btheobald/swansong/boardartswiftneg.png

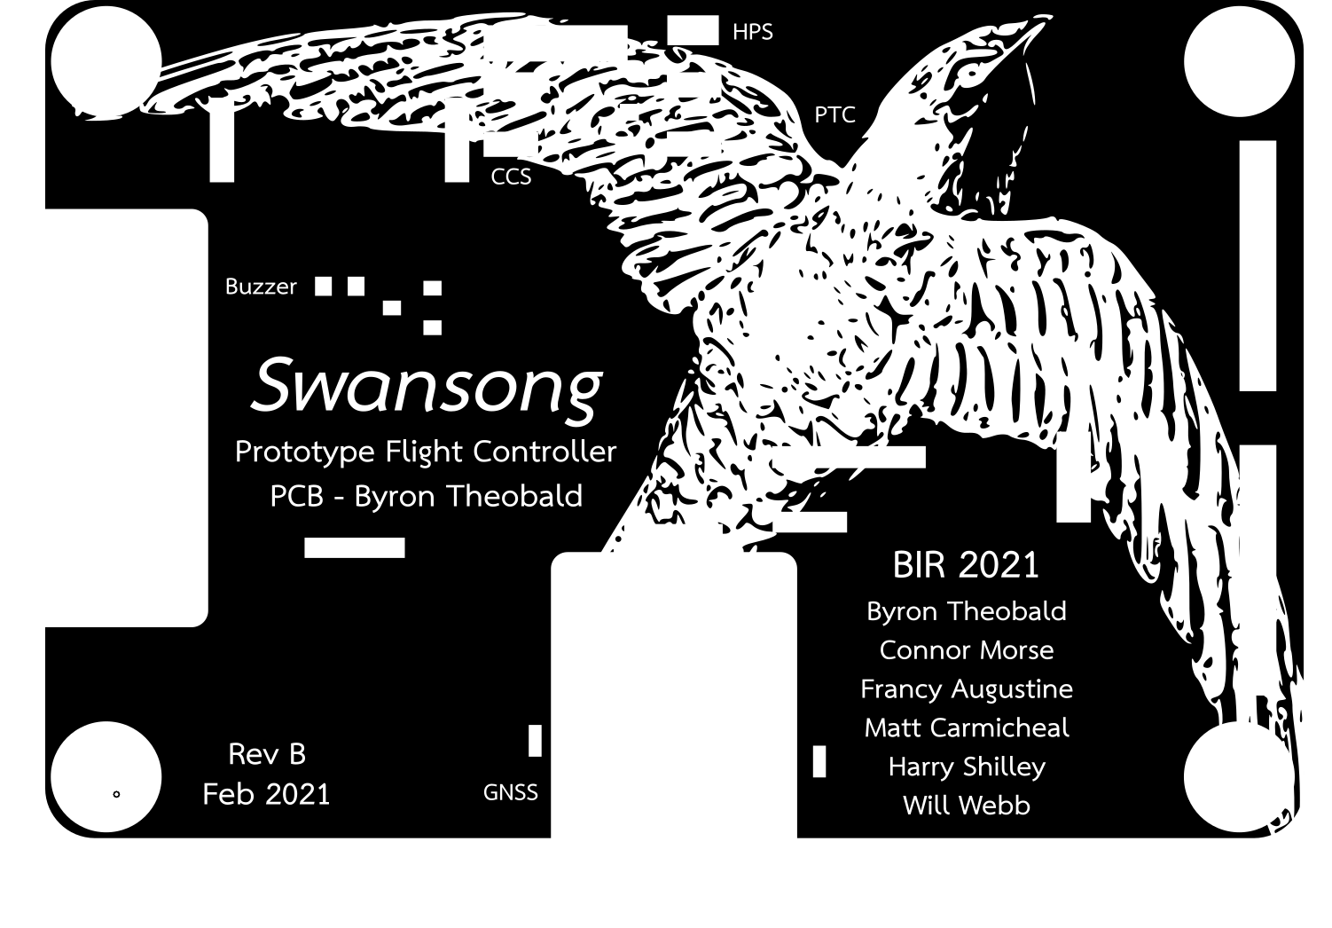
boardartswiftneg.png
