btheobald/swansong/boardartswiftpos.png

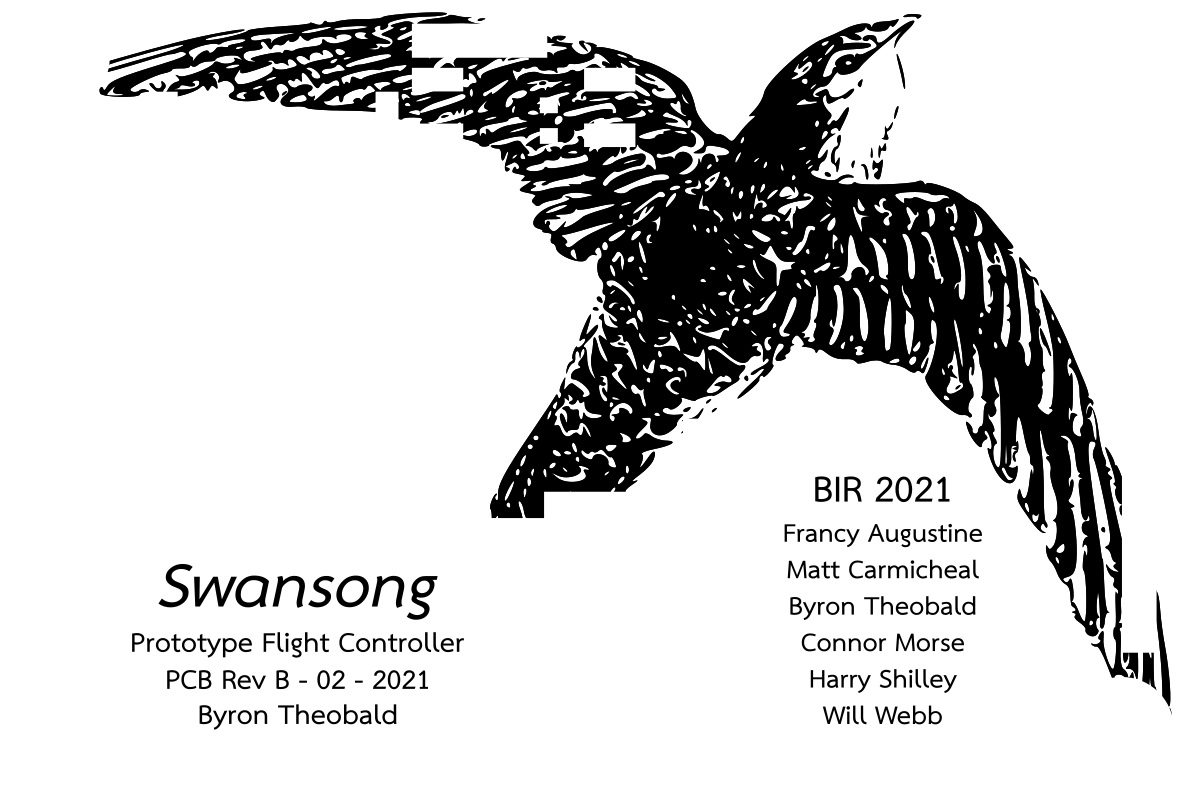
boardartswiftpos.png
