btheobald/swansong/rect2757.png

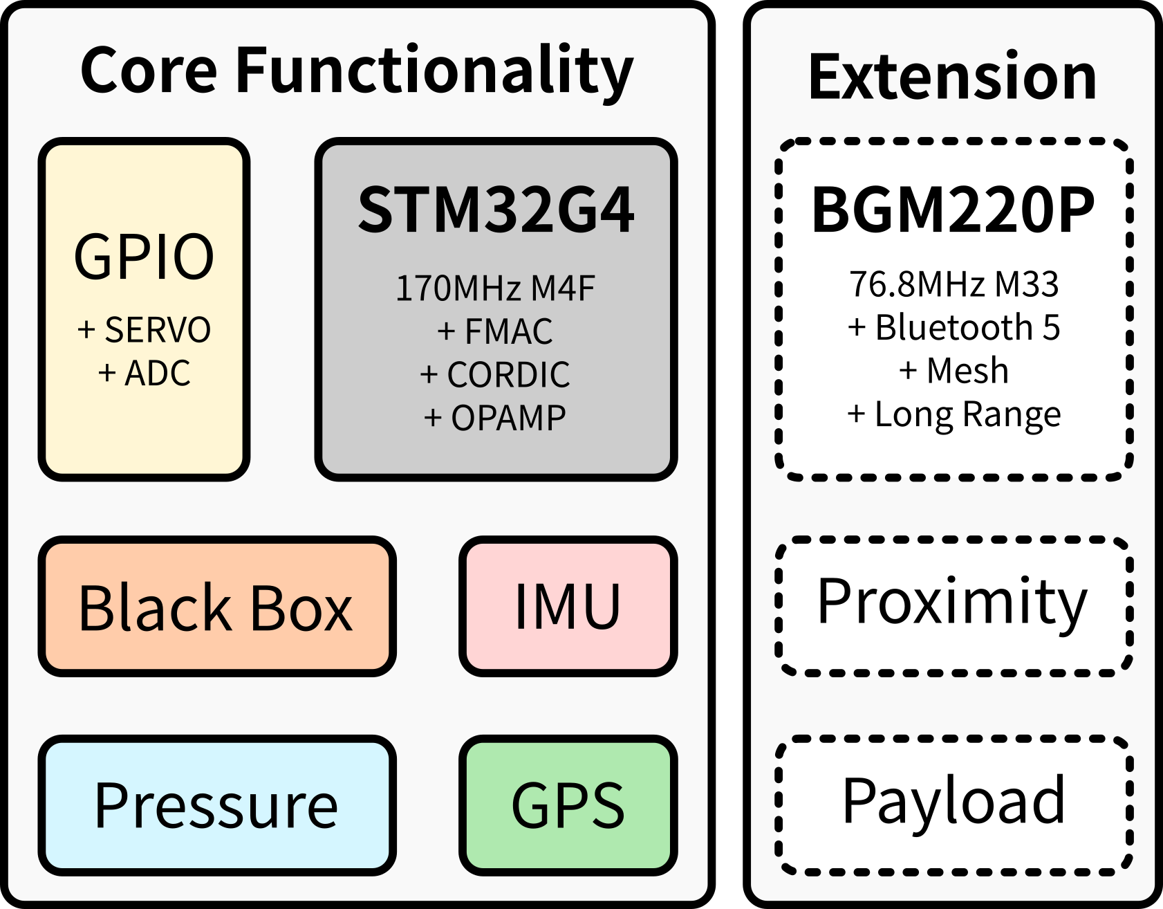
rect2757.png
