btheobald/swansong/glider/bom.ods

Reference | Quantity | Value | Footprint | Order Number | Min Qty | Price | Actual Order Qty | Phase 1 Order Price
C10 C11 C12 C13 C17 C26 | 6 | 4.7u | 0603 10V | 3013398 | 10 | 0.0325 | 20 | 0.65
C1 C2 C5 C6 C7 C9 C14 C15 C16 C18 C19 C20 C21 C23 C25 C27 C28 C29 C30 C33 C42 | 21 | 0.1u | 0402 10V | 2627343 | 100 | 0.0058 | 100 | 0.58
C3 C4 | 2 | 12p | 0402 50V | 3369114 | 10 | 0.0205 | 10 | 0.205
C8 C22 C31 C32 C34 C35 C36 C37 C38 C39 C40 C41 | 12 | 10u | 0805 16V | 3013453 | 50 | 0.0485 | 50 | 2.425
D2 D9 D8 D6 | 4 | Green | LED 0603 | 2290328 | 5 | 0.1704 | 10 | 1.704
D1 D5 D7 D4 | 4 | Red | LED 0603 | 2099224 | 5 | 0.1452 | 10 | 1.452
D3 | 1 | D_Schottky | Diode_SMD:D_SOD-123 | 2400193 | 5 | 0.3384 | 5 | 1.692
F1 | 1 | 1.5A | 1.5A 8VDC 1206 PTC | 2834894 | 1 | 0.1824 | 2 | 0.3648
J19 | 1 | Micro_SD_Card | DM3CS-SF | 1764376 | 1 | 1.332 | 2 | 2.664
J1 | 1 | USB_B_Micro | Connector_USB:USB_Micro-B_Molex_47346-0001 | 1568026 | 1 | 0.8964 | 2 | 1.7928
LS1 | 1 | Speaker | PKLCS1212E40A1-R1 | 2443208 | 1 | 0.9588 | 2 | 1.9176
Q1 | 1 | Q_PMOS_DGS | Package_TO_SOT_SMD:SOT-23 | 3577037 | 5 | 0.1812 | 5 | 0.906
Q2 Q3 | 2 | Q_NMOS_DGS | Package_TO_SOT_SMD:SOT-23 | 3577032 | 5 | 0.0403 | 5 | 0.2015
R1 | 1 | 2k | Resistor_SMD:R_0603_1608Metric | 2502426 | 10 | 0.0042 | 10 | 0.042
R11 R12 | 2 | 5.7k | Resistor_SMD:R_0603_1608Metric | 2670834 | 10 | 0.0042 | 10 | 0.042
R13 R14 R18 R21 | 4 | 0 | Resistor_SMD:R_0402_1005Metric | 2668188 | 10 | 0.0036 | 20 | 0.072
R4 | 1 | 0.1 | Resistor_SMD:R_1210_3225Metric | 3399742 | 1 | 0.2916 | 2 | 0.5832
R3 R5 R6 R7 R16 R19 R23 R24 R25 R26 R27 R30 | 12 | 100k | Resistor_SMD:R_0603_1608Metric | 2502398 | 10 | 0.014 | 40 | 0.56
R2 R8 R9 R10 R15 R17 R20 R29 R31 | 9 | 1k | Resistor_SMD:R_0603_1608Metric | 2502396 | 10 | 0.0148 | 20 | 0.296
SW1, SW2, SW3, SW4 | 4 | NCP_USER | PTS810 260gf | 3023215 | 10 | 0.1812 | 10 | 1.812
U10 | 1 | MIC5504-1.8YM5-TR | Package_TO_SOT_SMD:SOT-23-5 | 2809977 | 1 | 0.109 | 2 | 0.218
U11 | 1 | NTB0104BQ | 14-DHVQFN | 2890102 | 1 | 1.044 | 2 | 2.088
U2 | 1 | STM32G484RETx | Package_QFP:LQFP-64_10x10mm_P0.5mm | 3132422 | 1 | 7.092 | 2 | 14.184
U3 | 1 | MIC5501-3.0YM5-TR | Package_TO_SOT_SMD:SOT-23-5 | 2857640 | 1 | 0.109 | 2 | 0.218
U4 | 1 | MCP73831-2-OT | Package_TO_SOT_SMD:SOT-23-5 | 1332158 | 1 | 0.5544 | 2 | 1.1088
U5 | 1 | MS5637 | atlas:QFN-4_3x3_Pitch2mm | 3397823 | 1 | 2.748 | 2 | 5.496
U6 | 1 | AT25SF641-SUB-T | 8-WSOIC | 2988514 | 1 | 1.1208 | 2 | 2.2416
U7 | 1 | ICM-20948 | Package_DFN_QFN:QFN-24-1EP_3x3mm_P0.4mm_EP1.75x1.6mm | 2911498 | 1 | 6.696 | 2 | 13.392
U8 | 1 | L96-M33 | atlas:L96 | https://www.aliexpress.com/item/10000106848456.html | 1 | 6.9 | 2 | 13.8
Y1 | 1 | 8MHz | Crystal:Crystal_SMD_SeikoEpson_FA238-4Pin_3.2x2.5mm | 3501659 | 1 | 0.9084 | 2 | 1.8168
 |  |  |  |  |  |  | Total | 74.5251
