btheobald/swansong/glider/DM3CS-SF.stp

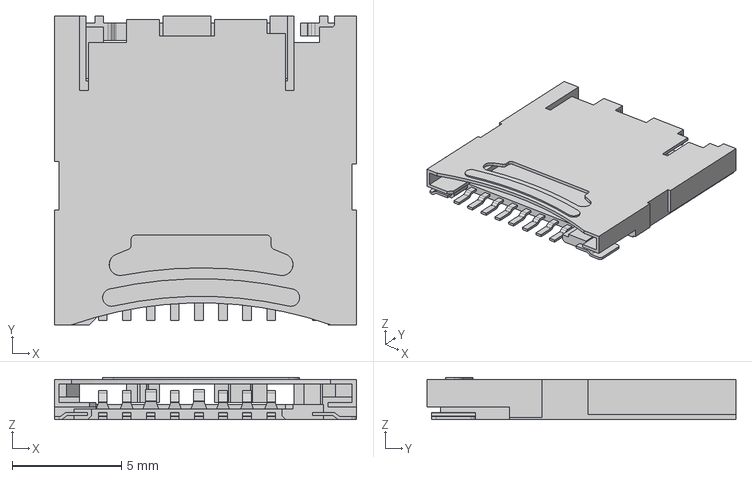
[picture p4: CAD file, 2021-02-24]
glider/DM3CS-SF.stp
13.8 x 14.1 x 1.93 mm
