btheobald/swansong/glider/glider.kicad_pcb

## KiCad design glider/glider.kicad_pcb (2021-03-01)

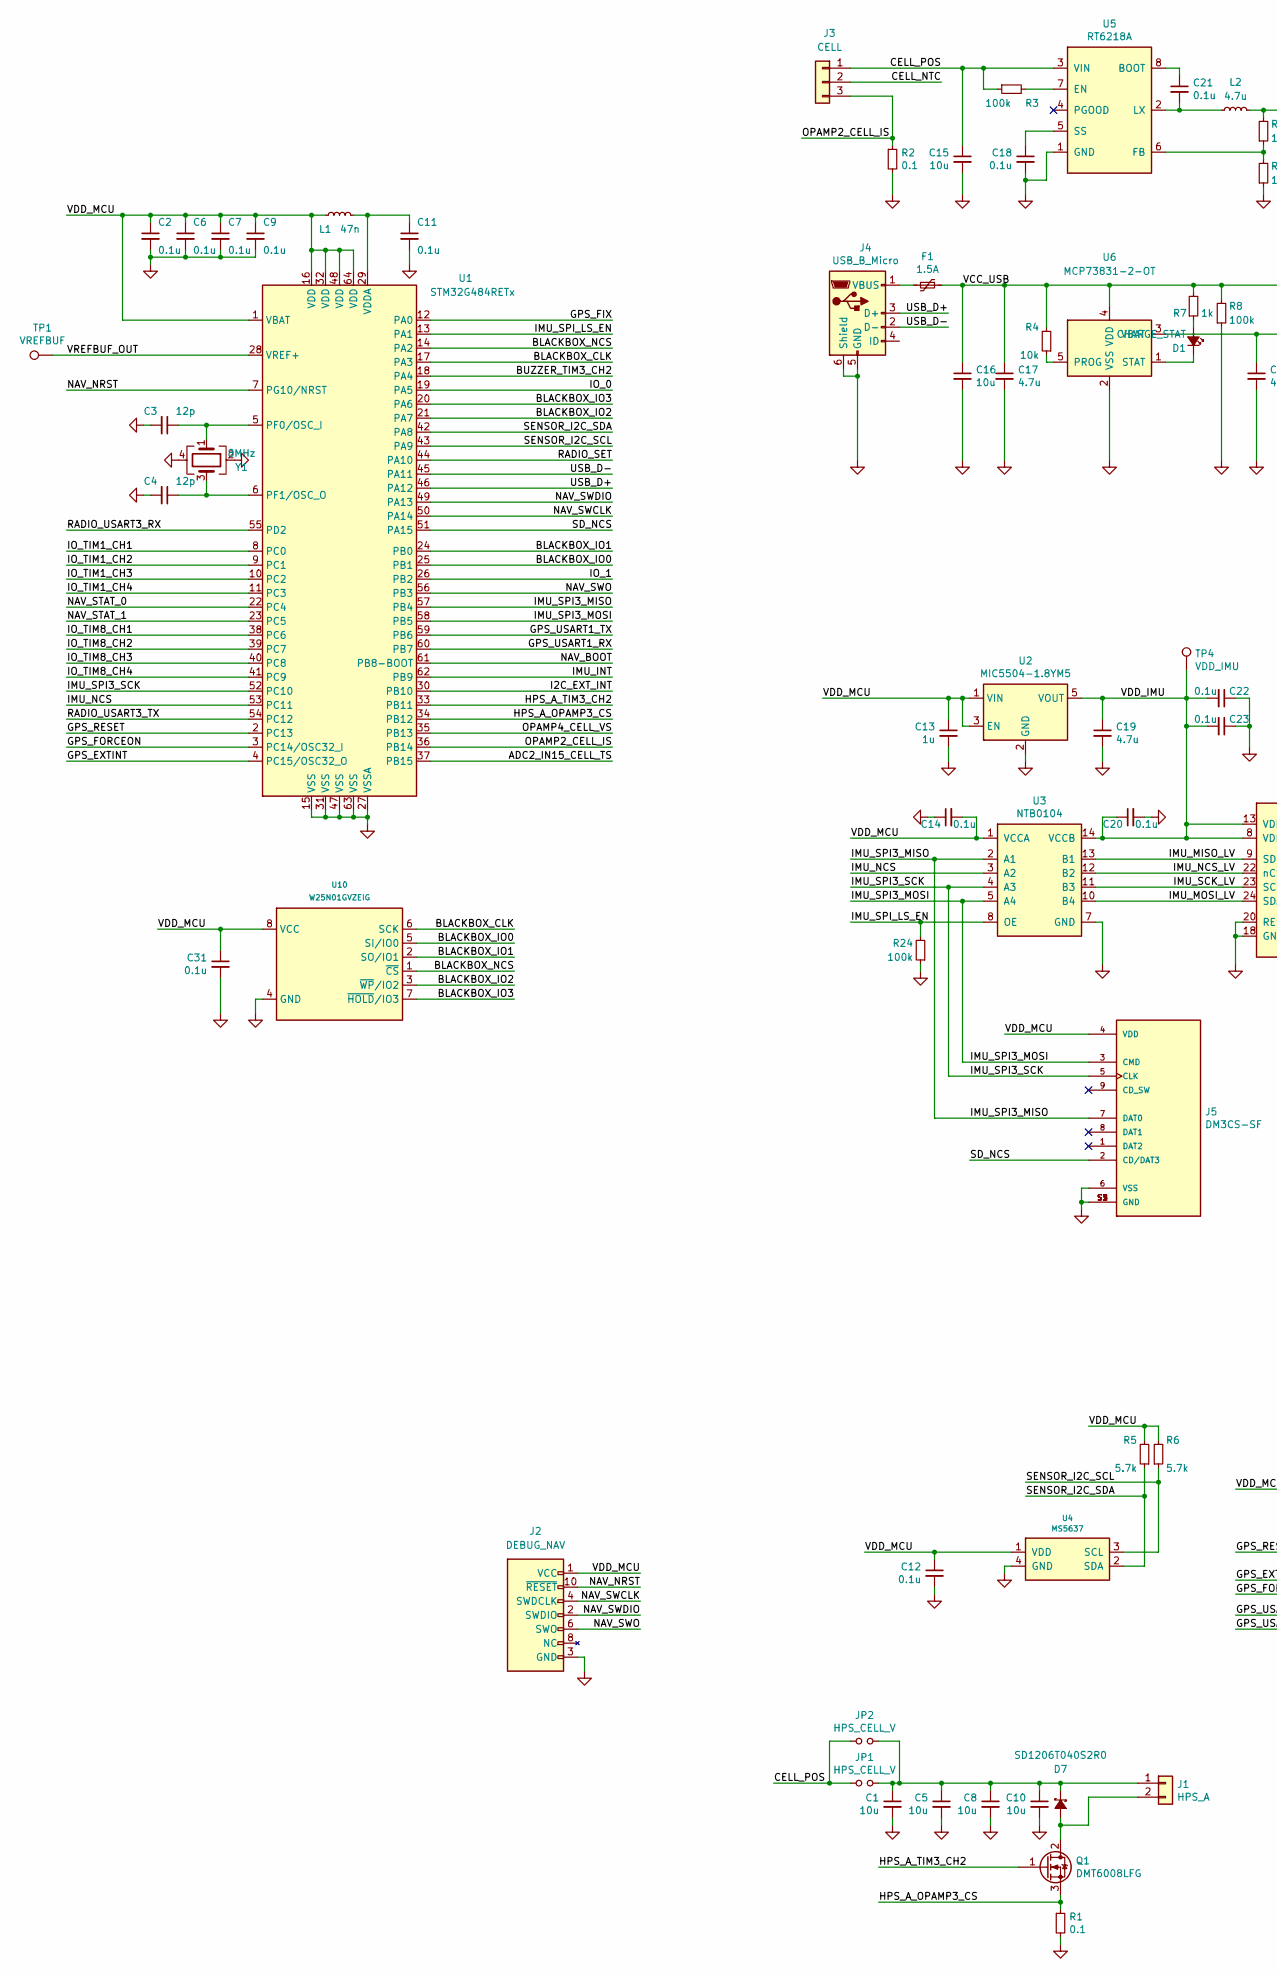
[picture p5: schematic glider.sch, part in row 1, column 1]

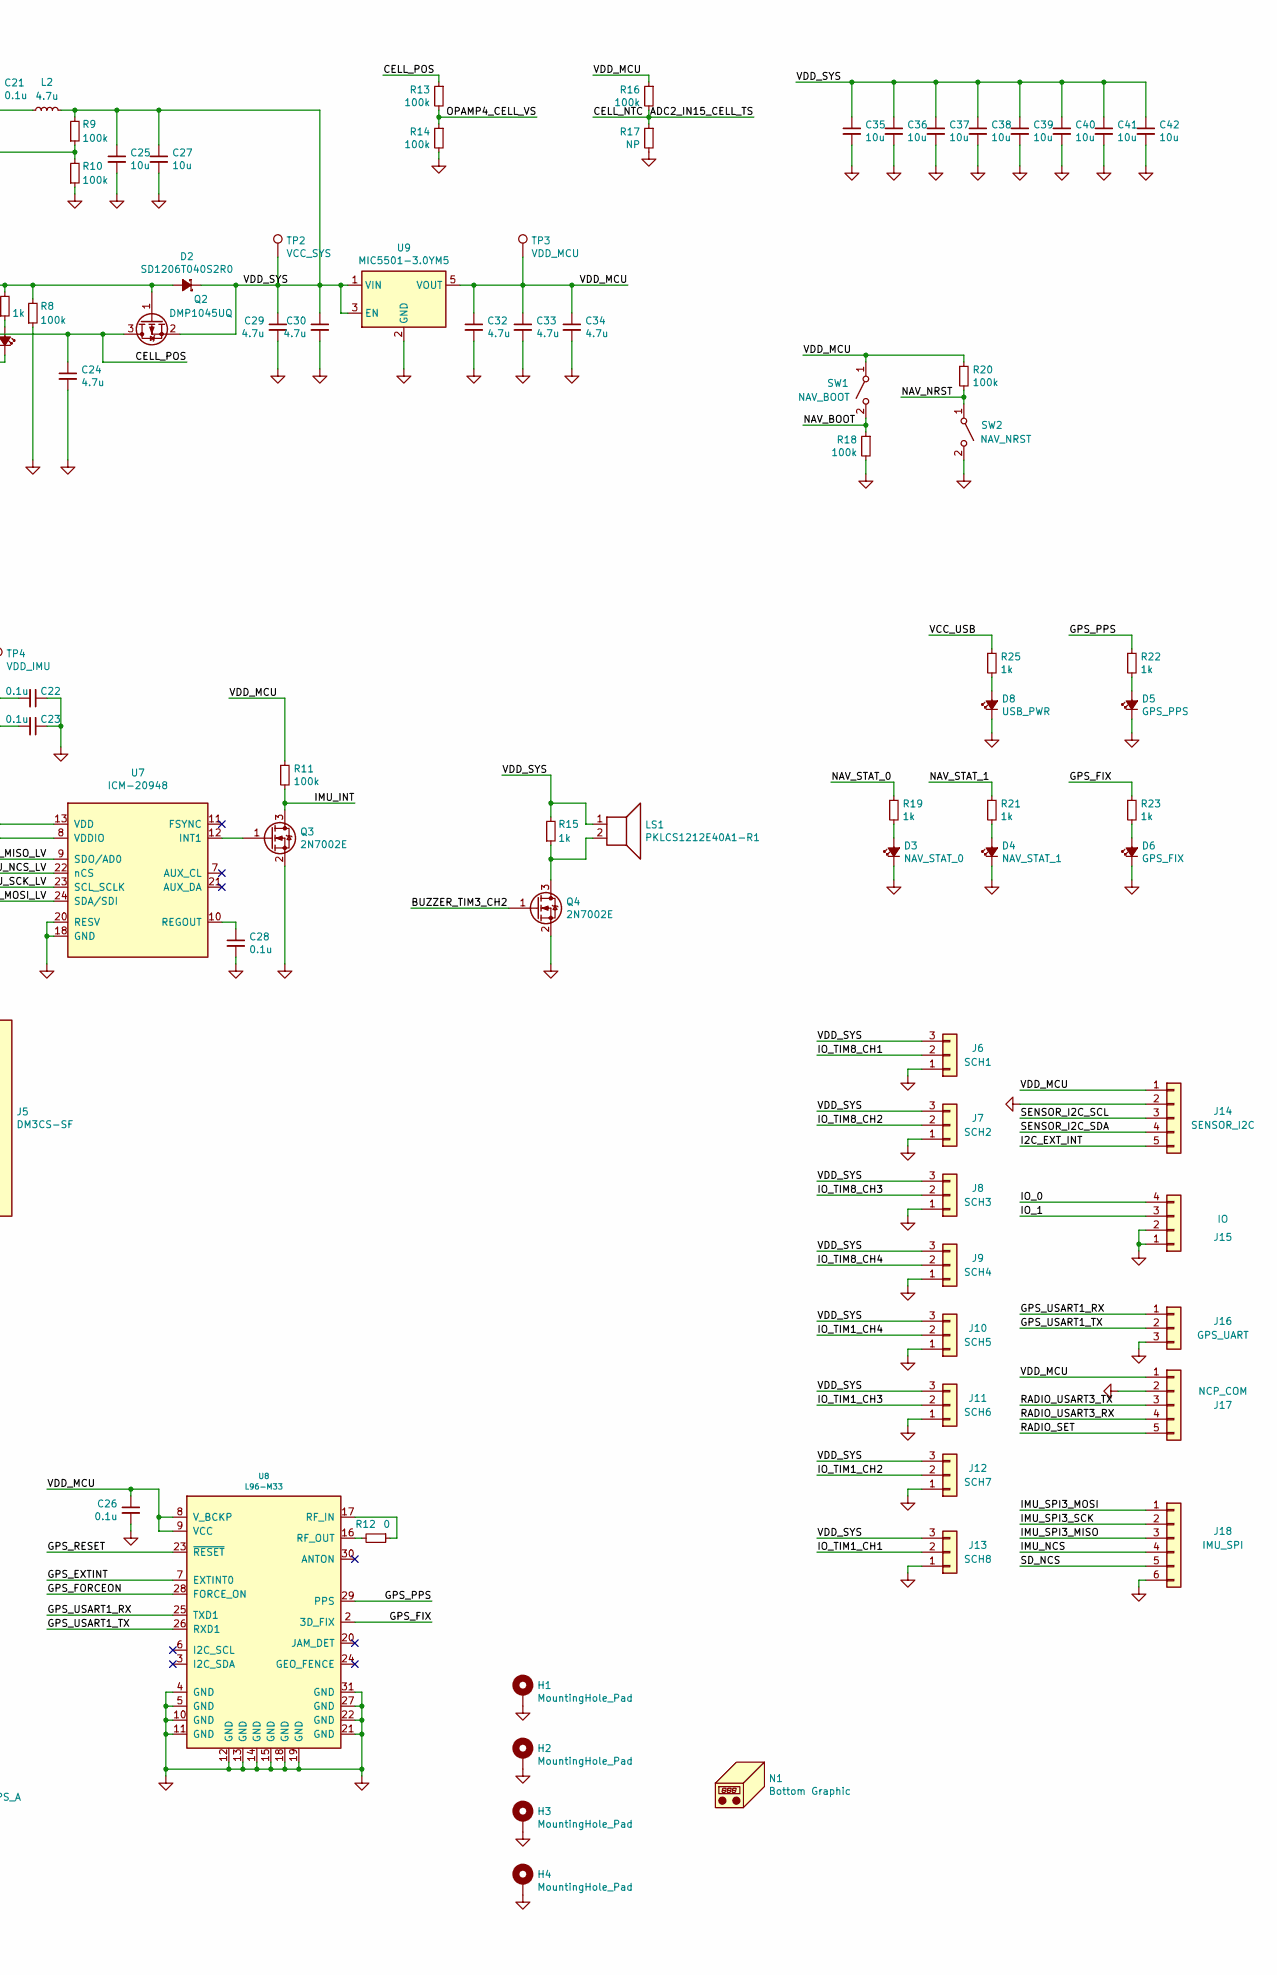
[picture p6: schematic glider.sch, part in row 1, column 2]

Parts:
C1, C5, C8, C10: 10u; C_1206_3216Metric
C2, C6, C7, C9, C11, C12, C14, C18, C20, C21, C22, C23, C26, C28, C31: 0.1u; C_0402_1005Metric
C3, C4: 12p; C_0402_1005Metric
C13: 1u; C_0805_2012Metric
C15, C16, C25, C27, C35, C36, C37, C38, C39, C40, C41, C42: 10u; C_0805_2012Metric
C17, C19, C24, C29, C30, C32, C33, C34: 4.7u; C_0805_2012Metric
D1: CHARGE_STAT; LED_0603_1608Metric
D2, D7: SD1206T040S2R0; D_SOD-123
D3: NAV_STAT_0; LED_0603_1608Metric
D4: NAV_STAT_1; LED_0603_1608Metric
D5: GPS_PPS; LED_0603_1608Metric
D6: GPS_FIX; LED_0603_1608Metric
D8: USB_PWR; LED_0603_1608Metric
F1: 1.5A; R_1210_3225Metric
H1, H2, H3, H4: MountingHole_Pad; MountingHole_2.5mm_Pad_Via
J1: HPS_A; R_2816_7142Metric_Pad3.20x4.45mm_HandSolder
J2: DEBUG_NAV; PinHeader_2x05_P1.27mm_Vertical_SMD
J3: CELL; PinSocket_1x03_P2.54mm_Vertical
J4: USB_B_Micro; USB_Micro-B_Molex_47346-0001
J5: DM3CS-SF; HRS_DM3CS-SF; PARTREV n/a
J6: SCH1; PinHeader_1x03_P2.54mm_Vertical
J7: SCH2; PinHeader_1x03_P2.54mm_Vertical
J8: SCH3; PinHeader_1x03_P2.54mm_Vertical
J9: SCH4; PinHeader_1x03_P2.54mm_Vertical
J10: SCH5; PinHeader_1x03_P2.54mm_Vertical
J11: SCH6; PinHeader_1x03_P2.54mm_Vertical
J12: SCH7; PinHeader_1x03_P2.54mm_Vertical
J13: SCH8; PinHeader_1x03_P2.54mm_Vertical
J14: SENSOR_I2C; PinHeader_1x05_P2.54mm_Vertical
J15: IO; PinHeader_1x04_P1.27mm_Vertical
J16: GPS_UART; PinHeader_1x03_P1.27mm_Vertical
J17: NCP_COM; PinHeader_1x05_P2.54mm_Vertical
J18: IMU_SPI; PinHeader_1x06_P1.27mm_Vertical
JP1, JP2: HPS_CELL_V; SolderJumper-2_P1.3mm_Open_TrianglePad1.0x1.5mm
L1: 47n; L_0402_1005Metric
L2: 4.7u; L_Bourns-SRN4018
LS1: PKLCS1212E40A1-R1; PKLCS1212
N1: Bottom Graphic; boardartswift
Q1: DMT6008LFG; Diodes_PowerDI3333-8
Q2: DMP1045UQ; SOT-23
Q3, Q4: 2N7002E; SOT-23
R1, R2: 0.1; R_1210_3225Metric
R3, R8, R9, R10, R11, R13, R14, R16, R18, R20, R24: 100k; R_0603_1608Metric
R4: 10k; R_0603_1608Metric
R5, R6: 5.7k; R_0603_1608Metric
R7, R15, R19, R21, R22, R23, R25: 1k; R_0603_1608Metric
R12: 0; R_0402_1005Metric
R17: NP; R_0603_1608Metric
SW1: NAV_BOOT; SW_SPST_PTS810
SW2: NAV_NRST; SW_SPST_PTS810
TP1: VREFBUF; TestPoint_THTPad_D1.0mm_Drill0.5mm
TP2: VCC_SYS; TestPoint_THTPad_D1.0mm_Drill0.5mm
TP3: VDD_MCU; TestPoint_THTPad_D1.0mm_Drill0.5mm
TP4: VDD_IMU; TestPoint_THTPad_D1.0mm_Drill0.5mm
U1: STM32G484RETx; LQFP-64_10x10mm_P0.5mm
U2: MIC5504-1.8YM5; SOT-23-5
U3: NTB0104; WQFN-14-1EP_2.5x3mm_P0.5mm_EP1.45x1.00mm
U4: MS5637; QFN-4_3x3_Pitch2mm
U5: RT6218A; SOT-23-8
U6: MCP73831-2-OT; SOT-23-5
U7: ICM-20948; QFN-24-1EP_3x3mm_P0.4mm_EP1.75x1.6mm
U8: L96-M33; L96
U9: MIC5501-3.0YM5; SOT-23-5
U10: W25N01GVZEIG; WSON-8x6mm-Pad-3.4x4.3mm
Y1: 8MHz; Crystal_SMD_SeikoEpson_FA238-4Pin_3.2x2.5mm

Connections:
/ADC2_IN15_CELL_TS: J3.2, R16.2, R17.1, U1.37 (PB15)
/BLACKBOX_CLK: U1.17 (PA3), U10.6 (SCK)
/BLACKBOX_IO0: U1.25 (PB1), U10.5 (SI/IO0)
/BLACKBOX_IO1: U1.24 (PB0), U10.2 (SO/IO1)
/BLACKBOX_IO2: U1.21 (PA7), U10.3 (~WP~/IO2)
/BLACKBOX_IO3: U1.20 (PA6), U10.7 (~HOLD~/IO3)
/BLACKBOX_NCS: U1.14 (PA2), U10.1 (~CS)
/BUZZER_TIM3_CH2: Q4.1 (G), U1.18 (PA4)
/CELL_POS: C15.1, C24.1, J3.1, JP1.1, JP2.1, Q2.3 (D), R3.1, R13.1, U5.3 (VIN), U6.3 (VBAT)
/GPS_EXTINT: U1.4 (PC15/OSC32_O), U8.7 (EXTINT0)
/GPS_FIX: R23.1, U1.12 (PA0), U8.2 (3D_FIX)
/GPS_FORCEON: U1.3 (PC14/OSC32_I), U8.28 (FORCE_ON)
/GPS_PPS: R22.1, U8.29 (PPS)
/GPS_RESET: U1.2 (PC13), U8.23 (~RESET)
/GPS_USART1_RX: J16.1, U1.60 (PB7), U8.25 (TXD1)
/GPS_USART1_TX: J16.2, U1.59 (PB6), U8.26 (RXD1)
/HPS_A_OPAMP3_CS: Q1.3 (S), R1.1, U1.34 (PB12)
/HPS_A_TIM3_CH2: Q1.1 (G), U1.33 (PB11)
/I2C_EXT_INT: J14.5, U1.30 (PB10)
/IMU_INT: Q3.3 (D), R11.2, U1.62 (PB9)
/IMU_MISO_LV: U3.13 (B1), U7.9 (SDO/AD0)
/IMU_MOSI_LV: U3.10 (B4), U7.24 (SDA/SDI)
/IMU_NCS: J18.4, U1.53 (PC11), U3.3 (A2)
/IMU_NCS_LV: U3.12 (B2), U7.22 (nCS)
/IMU_SCK_LV: U3.11 (B3), U7.23 (SCL_SCLK)
/IMU_SPI3_MISO: J5.7 (DAT0), J18.3, U1.57 (PB4), U3.2 (A1)
/IMU_SPI3_MOSI: J5.3 (CMD), J18.1, U1.58 (PB5), U3.5 (A4)
/IMU_SPI3_SCK: J5.5 (CLK), J18.2, U1.52 (PC10), U3.4 (A3)
/IMU_SPI_LS_EN: R24.2, U1.13 (PA1), U3.8 (OE)
/IO_0: J15.4, U1.19 (PA5)
/IO_1: J15.3, U1.26 (PB2)
/IO_TIM1_CH1: J13.2, U1.8 (PC0)
/IO_TIM1_CH2: J12.2, U1.9 (PC1)
/IO_TIM1_CH3: J11.2, U1.10 (PC2)
/IO_TIM1_CH4: J10.2, U1.11 (PC3)
/IO_TIM8_CH1: J6.2, U1.38 (PC6)
/IO_TIM8_CH2: J7.2, U1.39 (PC7)
/IO_TIM8_CH3: J8.2, U1.40 (PC8)
/IO_TIM8_CH4: J9.2, U1.41 (PC9)
/NAV_BOOT: R18.1, SW1.2 (B), U1.61 (PB8-BOOT)
/NAV_NRST: J2.10 (~RESET~), R20.2, SW2.1 (A), U1.7 (PG10/NRST)
/NAV_STAT_0: R19.1, U1.22 (PC4)
/NAV_STAT_1: R21.1, U1.23 (PC5)
/NAV_SWCLK: J2.4 (SWDCLK), U1.50 (PA14)
/NAV_SWDIO: J2.2 (SWDIO), U1.49 (PA13)
/NAV_SWO: J2.6 (SWO), U1.56 (PB3)
/OPAMP2_CELL_IS: J3.3, R2.1, U1.36 (PB14)
/OPAMP4_CELL_VS: R13.2, R14.1, U1.35 (PB13)
/RADIO_SET: J17.5, U1.44 (PA10)
/RADIO_USART3_RX: J17.4, U1.55 (PD2)
/RADIO_USART3_TX: J17.3, U1.54 (PC12)
/SD_NCS: J5.2 (CD/DAT3), J18.5, U1.51 (PA15)
/SENSOR_I2C_SCL: J14.3, R6.1, U1.43 (PA9), U4.3 (SCL)
/SENSOR_I2C_SDA: J14.4, R5.1, U1.42 (PA8), U4.2 (SDA)
/USB_D+: J4.3 (D+), U1.46 (PA12)
/USB_D-: J4.2 (D-), U1.45 (PA11)
/VCC_USB: C16.1, C17.1, D2.2 (A), F1.1, Q2.1 (G), R4.2, R7.2, R8.2, R25.1, U6.4 (VDD)
/VDD_IMU: C19.1, C20.1, C22.2, C23.2, TP4.1, U2.5 (VOUT), U3.14 (VCCB), U7.8 (VDDIO), U7.13 (VDD)
/VDD_MCU: C2.1, C6.1, C7.1, C9.1, C12.1, C13.1, C14.2, C26.1, C31.1, C32.1, C33.1, C34.1, J2.1 (VCC), J5.4 (VDD), J14.1, J17.1, L1.2, R5.2, R6.2, R11.1, R16.1, R20.1, SW1.1 (A), TP3.1, U1.1 (VBAT), U1.16 (VDD), U1.32 (VDD), U1.48 (VDD), U1.64 (VDD), U2.1 (VIN), U2.3 (EN), U3.1 (VCCA), U4.1 (VDD), U8.8 (V_BCKP), U8.9 (VCC), U9.5 (VOUT), U10.8 (VCC)
/VDD_SYS: C25.1, C27.1, C29.1, C30.1, C35.1, C36.1, C37.1, C38.1, C39.1, C40.1, C41.1, C42.1, D2.1 (K), J6.3, J7.3, J8.3, J9.3, J10.3, J11.3, J12.3, J13.3, L2.1, LS1.1, Q2.2 (S), R9.2, R15.2, TP2.1, U9.1 (VIN), U9.3 (EN)
/VREFBUF_OUT: TP1.1, U1.28 (VREF+)
GND: C1.2, C2.2, C3.2, C4.2, C5.2, C6.2, C7.2, C8.2, C9.2, C10.2, C11.2, C12.2, C13.2, C14.1, C15.2, C16.2, C17.2, C18.2, C19.2, C20.2, C22.1, C23.1, C24.2, C25.2, C26.2, C27.2, C28.2, C29.2, C30.2, C31.2, C32.2, C33.2, C34.2, C35.2, C36.2, C37.2, C38.2, C39.2, C40.2, C41.2, C42.2, D3.1 (K), D4.1 (K), D5.1 (K), D6.1 (K), D8.1 (K), H1.1, H2.1, H3.1, H4.1, J2.3 (GND), J2.5 (GND), J2.9 (GND), J4.5 (GND), J4.6 (Shield), J5.6 (VSS), J5.S1 (GND), J5.S2 (GND), J5.S3 (GND), J5.S5 (GND), J6.1, J7.1, J8.1, J9.1, J10.1, J11.1, J12.1, J13.1, J14.2, J15.1, J15.2, J16.3, J17.2, J18.6, Q3.2 (S), Q4.2 (S), R1.2, R2.2, R8.1, R10.1, R14.2, R17.2, R18.2, R24.1, SW2.2 (B), U1.15 (VSS), U1.27 (VSSA), U1.31 (VSS), U1.47 (VSS), U1.63 (VSS), U2.2 (GND), U3.7 (GND), U3.15 (GND), U4.4 (GND), U5.1 (GND), U6.2 (VSS), U7.18 (GND), U7.20 (RESV), U8.4 (GND), U8.5 (GND), U8.10 (GND), U8.11 (GND), U8.12 (GND), U8.13 (GND), U8.14 (GND), U8.15 (GND), U8.18 (GND), U8.19 (GND), U8.21 (GND), U8.22 (GND), U8.27 (GND), U8.31 (GND), U9.2 (GND), U10.4 (GND), U10.9 (GND), Y1.2, Y1.4
unnamed: C1.1, C5.1, C8.1, C10.1, D7.1 (K), J1.1, JP1.2, JP2.2
unnamed: C3.1, U1.5 (PF0/OSC_I), Y1.1
unnamed: C4.1, U1.6 (PF1/OSC_O), Y1.3
unnamed: C11.1, L1.1, U1.29 (VDDA)
unnamed: C18.1, U5.5 (SS)
unnamed: C21.1, U5.8 (BOOT)
unnamed: C21.2, L2.2, U5.2 (LX)
unnamed: C28.1, U7.10 (REGOUT)
unnamed: D1.1 (K), U6.1 (STAT)
unnamed: D1.2 (A), R7.1
unnamed: D3.2 (A), R19.2
unnamed: D4.2 (A), R21.2
unnamed: D5.2 (A), R22.2
unnamed: D6.2 (A), R23.2
unnamed: D7.2 (A), J1.2, Q1.2 (D)
unnamed: D8.2 (A), R25.2
unnamed: F1.2, J4.1 (VBUS)
unnamed: LS1.2, Q4.3 (D), R15.1
unnamed: Q3.1 (G), U7.12 (INT1)
unnamed: R3.2, U5.7 (EN)
unnamed: R4.1, U6.5 (PROG)
unnamed: R9.1, R10.2, U5.6 (FB)
unnamed: R12.1, U8.17 (RF_IN)
unnamed: R12.2, U8.16 (RF_OUT)

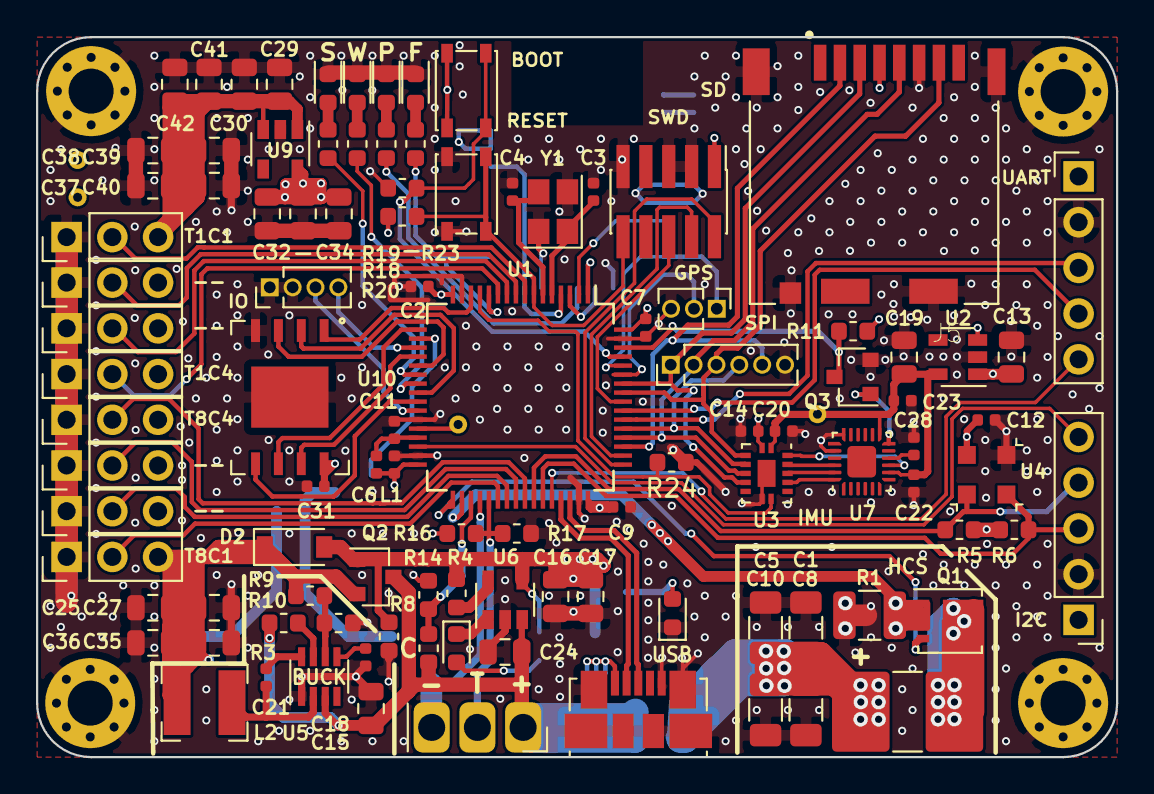
[picture p7: board glider.kicad_pcb from above]

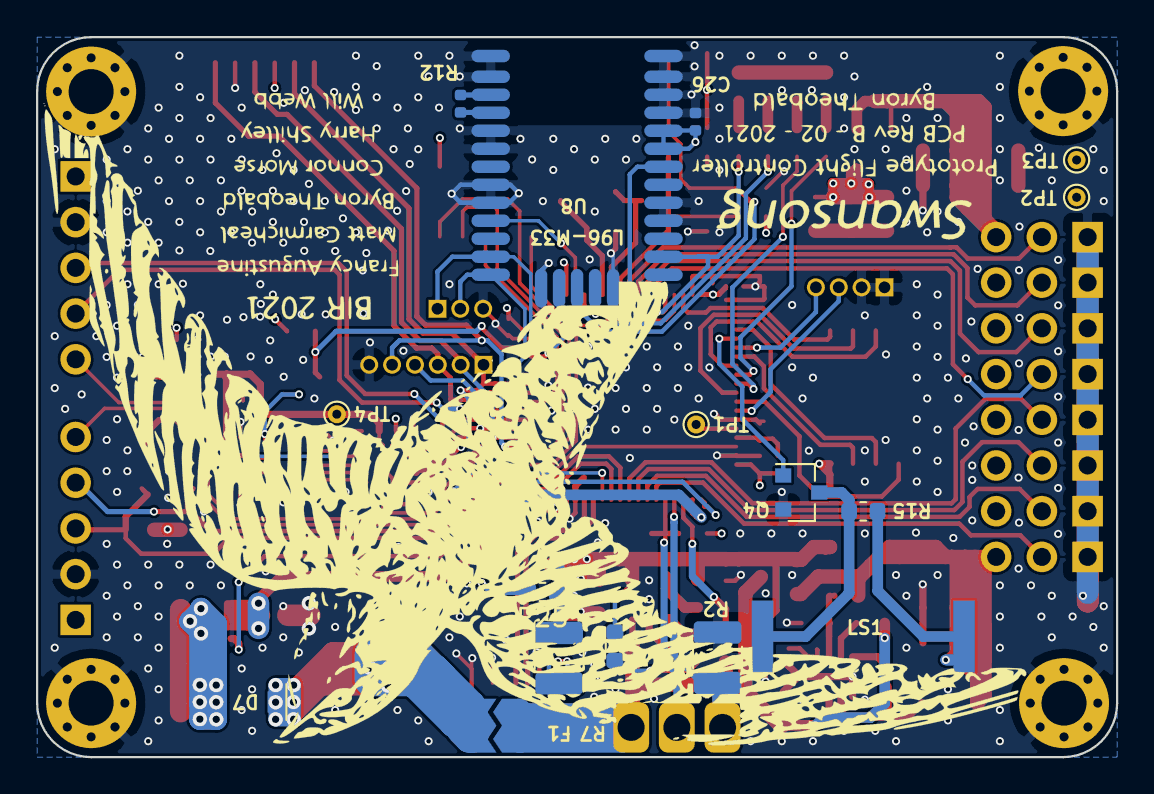
[picture p8: board glider.kicad_pcb from below]

Board: 4 copper layers, 60.0 x 40.0 mm, 125 parts (18 on the bottom side), 86 nets.
