btheobald/swansong/gliderxl/gliderxl.ioc

Mcu.UserName=STM32G484RETx
PA0.GPIO_Label=GPS_FIX
PA0.Signal=GPIO_Input
PA1.GPIO_Label=IMU_SPI_LS_EN
PA1.Signal=GPIO_Output
PA10.GPIO_Label=RADIO_SET
PA10.Signal=GPIO_Output
PA11.Signal=USB_DM
PA12.Signal=USB_DP
PA13.Signal=SYS_JTMS-SWDIO
PA14.Signal=SYS_JTCK-SWCLK
PA15.GPIO_Label=SD_NCS
PA15.Signal=GPIO_Output
PA2.Signal=QUADSPI1_BK1_NCS
PA3.Signal=QUADSPI1_CLK
PA4.GPIO_Label=BUZZER_DAC
PA4.Signal=GPIO_Output
PA5.Signal=OPAMP2_VINM0
PA6.Signal=QUADSPI1_BK1_IO3
PA7.Signal=QUADSPI1_BK1_IO2
PA8.GPIO_Label=SENSOR_I2C2_SDA
PA8.Signal=I2C2_SDA
PA9.GPIO_Label=SENSOR_I2C2_SCL
PA9.Signal=I2C2_SCL
PB0.Signal=QUADSPI1_BK1_IO1
PB1.Signal=QUADSPI1_BK1_IO0
PB11.GPIO_Label=HPS_A_TIM2_CH4
PB11.Signal=S_TIM2_CH4
PB12.GPIO_Label=HPS Current Sense A
PB12.Signal=OPAMP6_VINP
PB13.GPIO_Label=Battery Voltage Sense
PB13.Signal=OPAMP4_VINP
PB14.GPIO_Label=Battery Current Sense
PB14.Signal=OPAMP2_VINP
PB2.GPIO_Label=I2C_EXT_INT
PB2.Signal=GPIO_Input
PB3.Signal=SYS_JTDO-SWO
PB4.Signal=SPI3_MISO
PB5.Signal=SPI3_MOSI
PB6.GPIO_Label=GPS_USART1_TX
PB6.Signal=USART1_TX
PB7.GPIO_Label=GPS_USART1_RX
PB7.Signal=USART1_RX
PB8-BOOT0.GPIO_Label=USER_BTN
PB8-BOOT0.Signal=GPIO_Input
PB9.GPIO_Label=IMU_INT
PB9.Signal=GPIO_Output
PC0.Signal=S_TIM1_CH1
PC1.Signal=S_TIM1_CH2
PC10.Signal=SPI3_SCK
PC11.GPIO_Label=IMU_NCS
PC11.Signal=GPIO_Output
PC12.GPIO_Label=RADIO_UART5_TX
PC12.Signal=UART5_TX
PC13.GPIO_Label=GPS_RESET
PC13.Signal=GPIO_Output
PC14-OSC32_IN.GPIO_Label=GPS_FORCEON
PC14-OSC32_IN.Signal=GPIO_Output
PC15-OSC32_OUT.GPIO_Label=GPS_EXT_INT
PC15-OSC32_OUT.Signal=GPIO_Output
PC2.Signal=S_TIM1_CH3
PC3.Signal=S_TIM1_CH4
PC4.GPIO_Label=NAV_STAT_0
PC4.Signal=GPIO_Output
PC5.GPIO_Label=NAV_STAT_1
PC5.Signal=GPIO_Output
PC6.Signal=S_TIM8_CH1
PC7.Signal=S_TIM8_CH2
PC8.Signal=S_TIM8_CH3
PC9.Signal=S_TIM8_CH4
PD2.GPIO_Label=RADIO_UART5_RX
PD2.Signal=UART5_RX
PF0-OSC_IN.Signal=RCC_OSC_IN
PF1-OSC_OUT.Signal=RCC_OSC_OUT
