btheobald/swansong/(commit log)

2021-02-17 uploading files
    [glider.kicad_pcb, glider.sch]
2021-02-18 all components placed, initial board art
    [glider.kicad_pcb, glider.sch]
2021-02-23 final checkouts
    [bom.ods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]
2021-02-24 removed bt module again, shrunk board
    [DM3CS-SF.stp, glider.kicad_pcb, glider.sch]
2021-02-25 reved layout complete, silkscreen todo
    [glider.kicad_pcb, glider.sch]
2021-02-28 submitted to jlc
    [glider-B_Cu.gbr, glider-B_Mask.gbr, glider-B_Paste.gbr, glider-B_SilkS.gbr, glider-Edge_Cuts.gbr, glider-F_Cu.gbr, glider-F_Mask.gbr, glider-F_Paste.gbr]
2021-03-01 design in manufacture
    [glider.kicad_pcb]
2021-03-29 bulk changes
    [jlink-g4.cfg]
